fernandohar/pixelBoard/(commit log)

2021-03-18 Fix Compilation error caused by SDFat library being included in esp8266 library. Support esp8266 version 2.7.4
    [pixelArt.cpp, pixelArt.h, pixelBoardBase.h]
2026-06-26 Add hardware button setup menu
2026-06-26 Cycle modes with hardware up and down buttons
2026-06-26 Document ESP8266 hardware wiring
2026-06-26 Fix wiring diagram resistor alignment
2026-06-26 Fix ESP8266 core 3 compile errors
    [gameArkanoid.h, gameOfLife.h, gameSnake.cpp, gameSnake.h, gameTetris.h, pixelArt.cpp, pixelArt.h, pixelBoard.h]
